KidsLabDe/Robo-Buddy-Makerfestival26/hardware/powerboard/ansichten/2d_oben.png

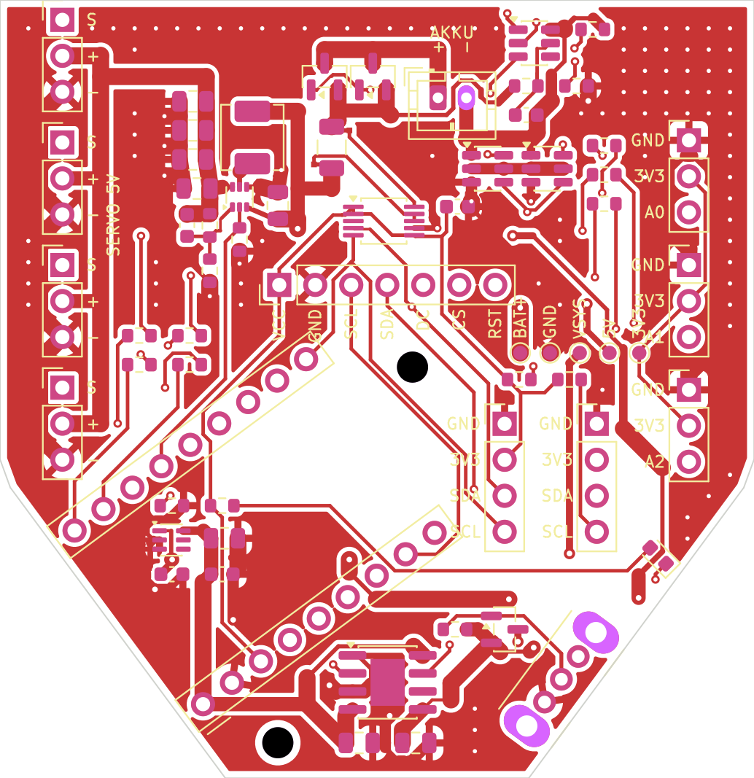
hardware/powerboard/ansichten/2d_oben.png
