KidsLabDe/Robo-Buddy-Makerfestival26/hardware/powerboard/ansichten/2d_unten.png

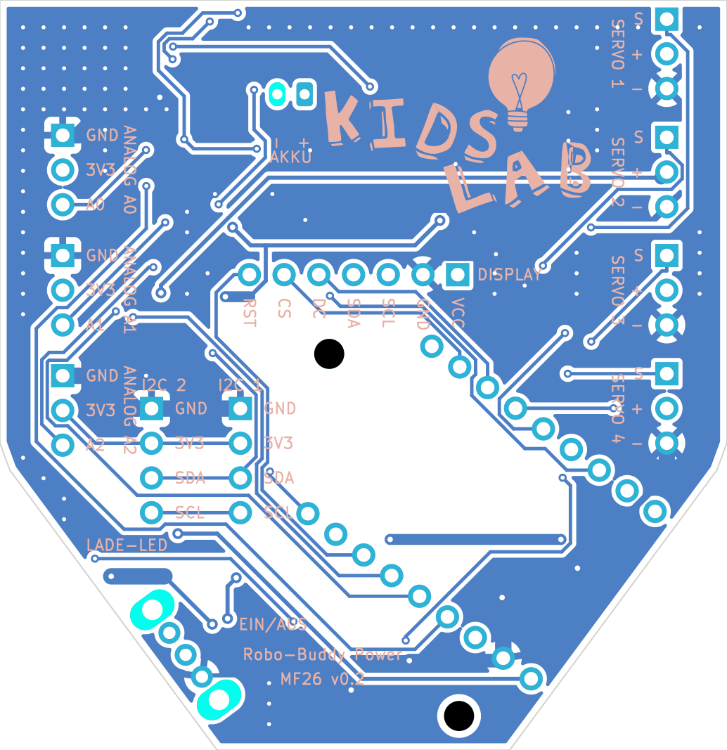
hardware/powerboard/ansichten/2d_unten.png
