KidsLabDe/Robo-Buddy-Makerfestival26/hardware/powerboard/ansichten/3d_oben.png

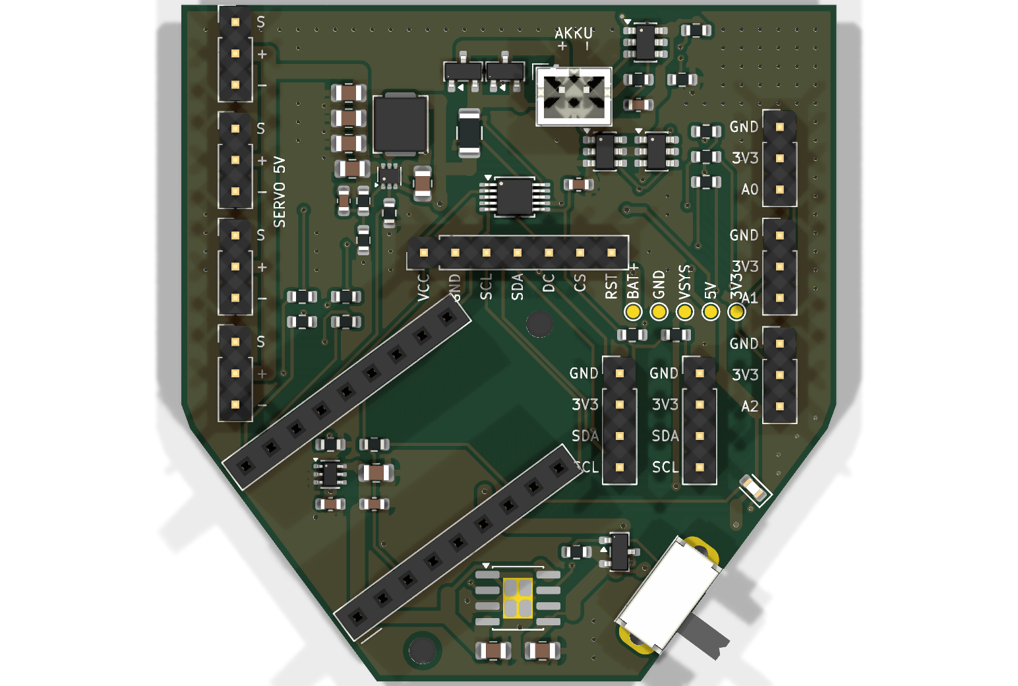
hardware/powerboard/ansichten/3d_oben.png
