KidsLabDe/Robo-Buddy-Makerfestival26/hardware/powerboard/ansichten/3d_schraeg.png

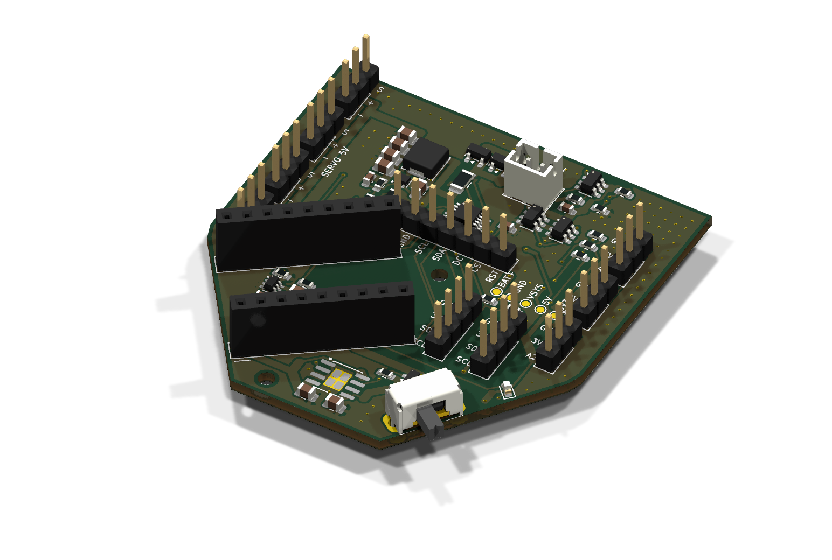
hardware/powerboard/ansichten/3d_schraeg.png
