KidsLabDe/Robo-Buddy-Makerfestival26/hardware/powerboard/ansichten/3d_unten.png

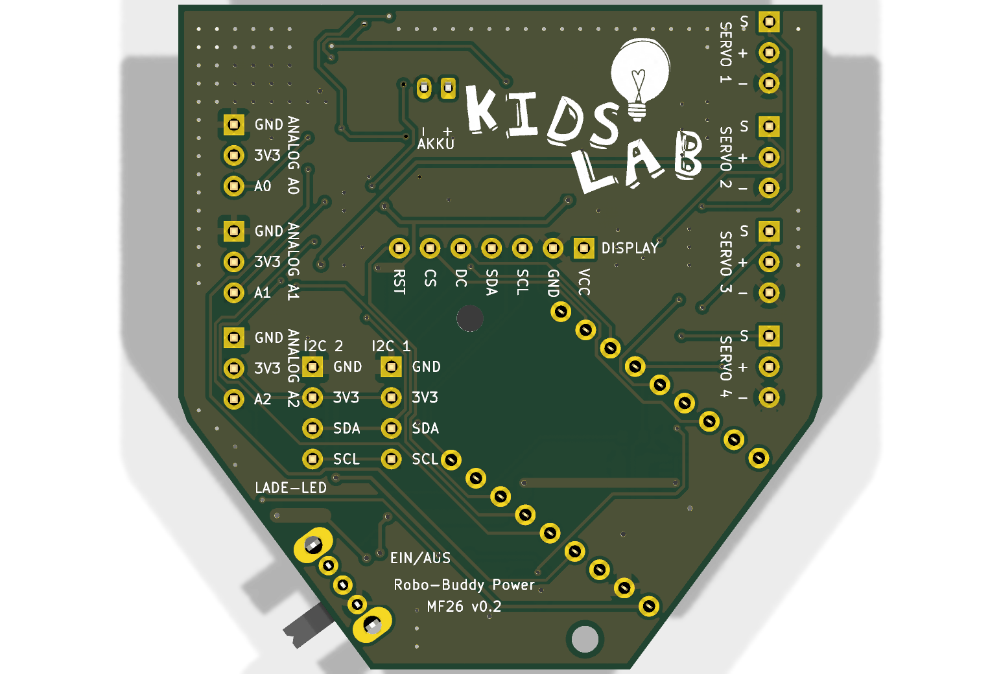
hardware/powerboard/ansichten/3d_unten.png
