KidsLabDe/Robo-Buddy-Makerfestival26/hardware/powerboard/ansichten/passung_schnitte.png

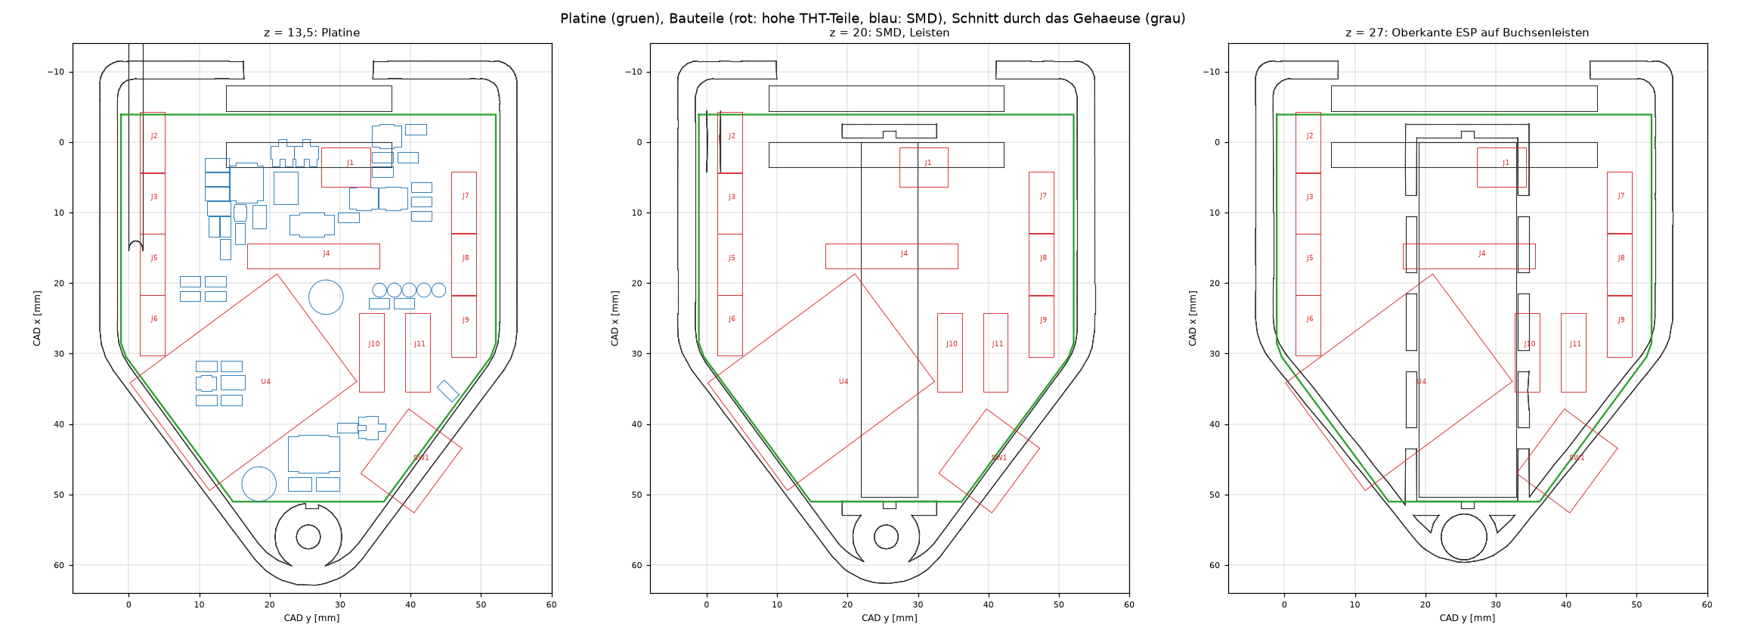
hardware/powerboard/ansichten/passung_schnitte.png
