KidsLabDe/Robo-Buddy-Makerfestival26/hardware/powerboard/ansichten/rework_u3_ce.png

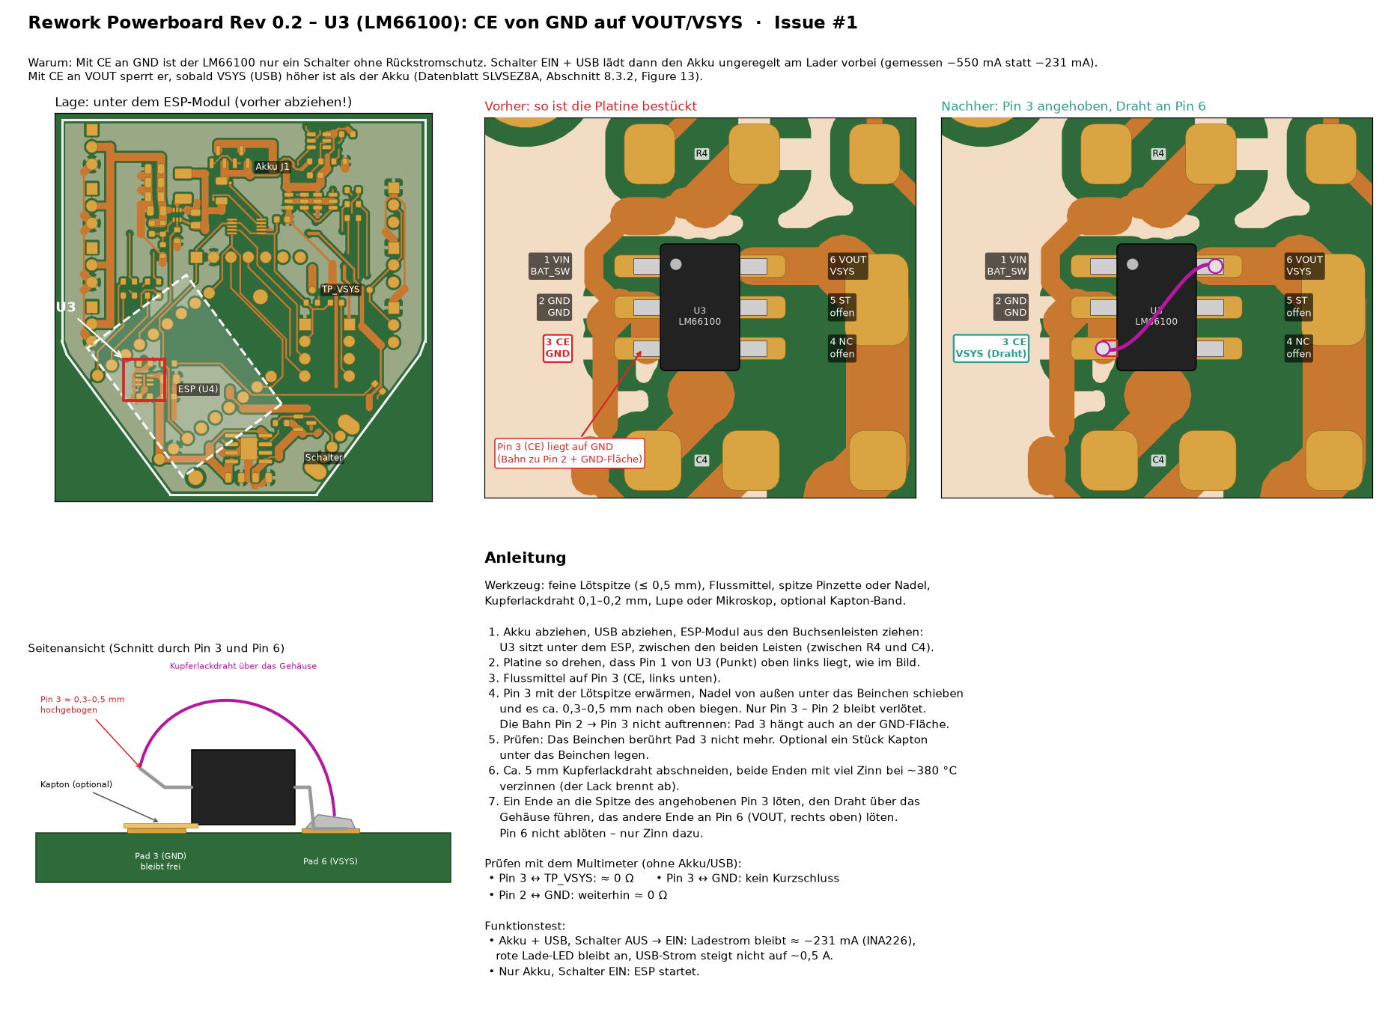
hardware/powerboard/ansichten/rework_u3_ce.png
