KidsLabDe/Robo-Buddy-Makerfestival26/cad/MF26-Roboter-Robot-Base.3mf

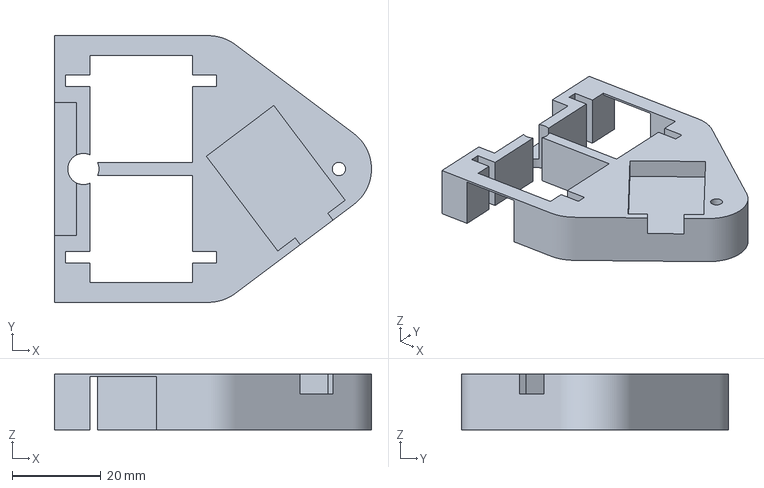
[picture p11: CAD file, 2026-10-15]
cad/MF26-Roboter-Robot-Base.3mf
71.3 x 60.0 x 12.5 mm
