KidsLabDe/Robo-Buddy-Makerfestival26/hardware/powerboard/ansichten/powerboard-umriss-loecher.dxf

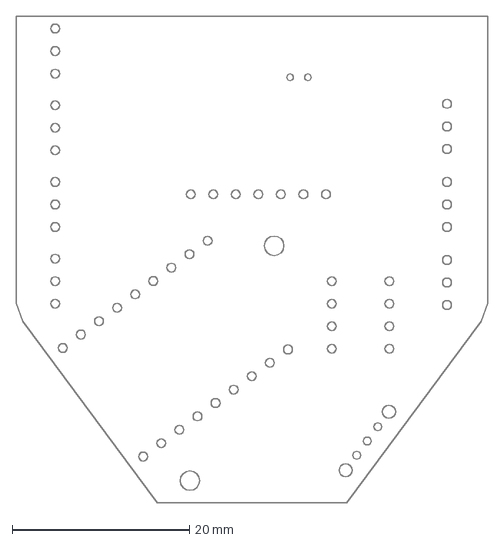
[picture p12: CAD file, 2026-10-22]
hardware/powerboard/ansichten/powerboard-umriss-loecher.dxf
53.2 x 54.9 mm
