KidsLabDe/Robo-Buddy-Makerfestival26/cad/MF26-Roboter-Dragwheel.3mf

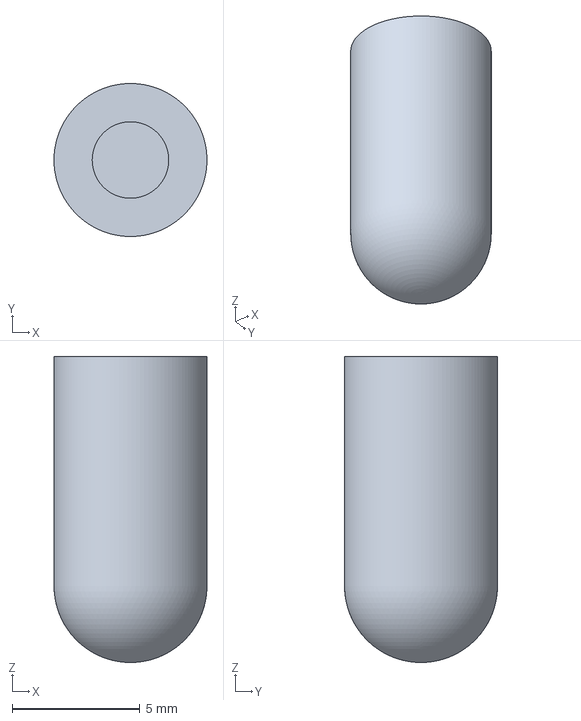
[picture p13: CAD file, 2026-10-15]
cad/MF26-Roboter-Dragwheel.3mf
6.00 x 6.00 x 12.0 mm
