KidsLabDe/Robo-Buddy-Makerfestival26/hardware/powerboard/ansichten/powerboard-umriss.dxf

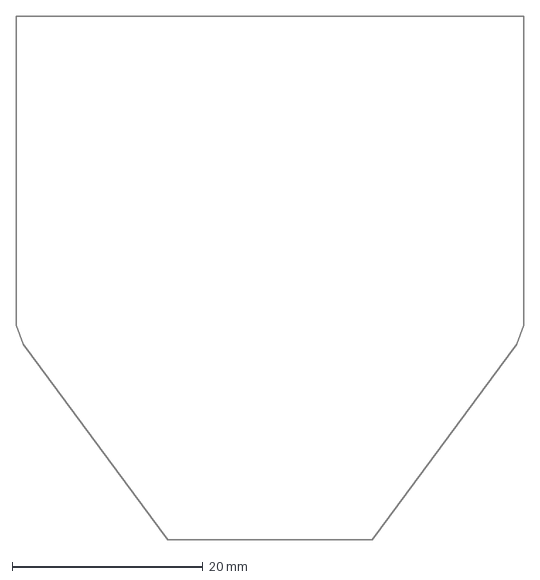
[picture p14: CAD file, 2026-10-22]
hardware/powerboard/ansichten/powerboard-umriss.dxf
53.2 x 54.9 mm
