KidsLabDe/Robo-Buddy-Makerfestival26/cad/MF26-Roboter-Rad.3mf

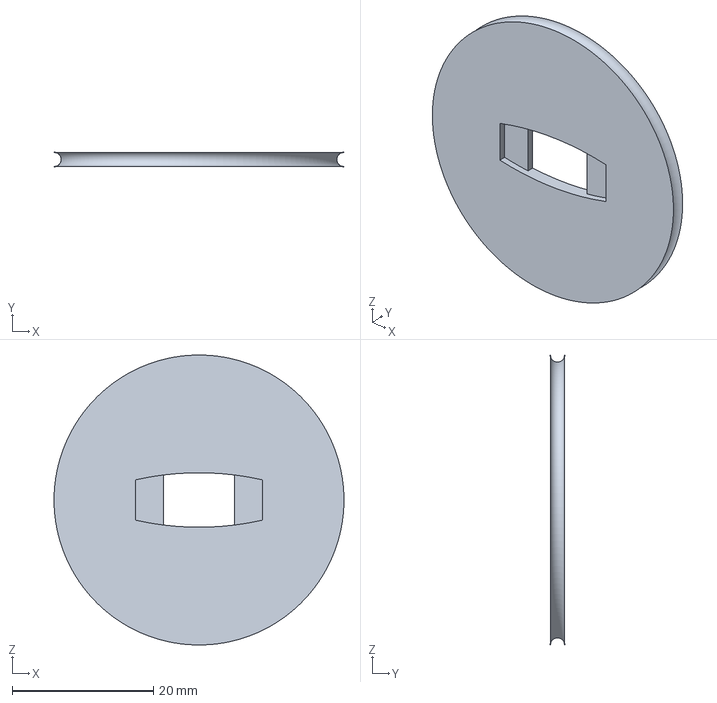
[picture p15: CAD file, 2026-10-15]
cad/MF26-Roboter-Rad.3mf
41.0 x 2.00 x 41.0 mm
