KidsLabDe/Robo-Buddy-Makerfestival26/cad/MF26-Roboter.step

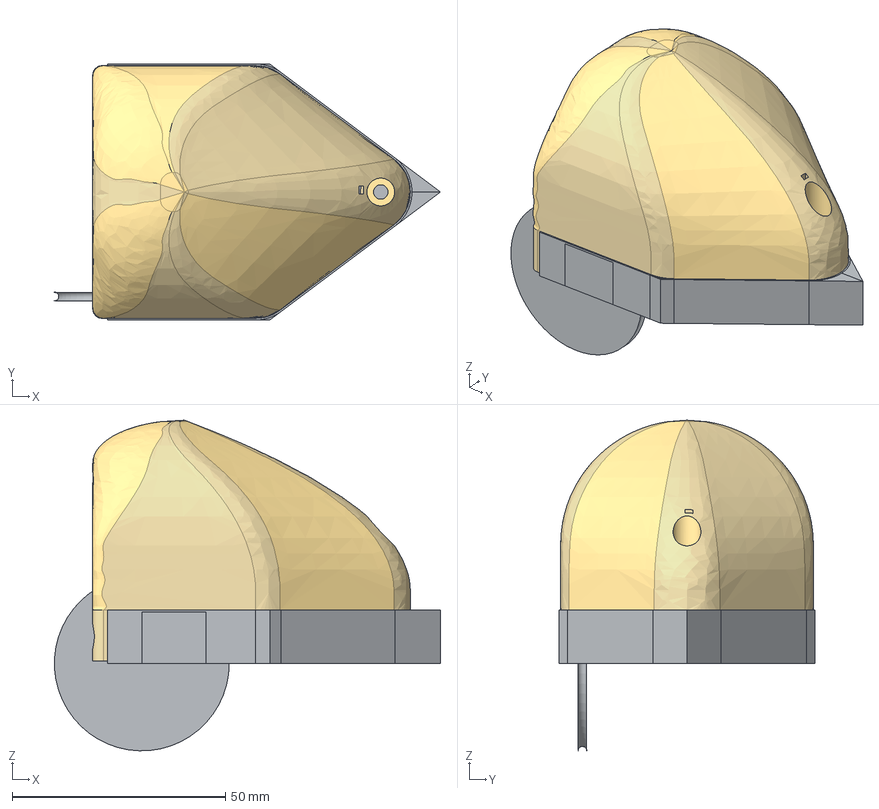
[picture p16: CAD file, 2026-10-08]
cad/MF26-Roboter.step
90.5 x 60.0 x 77.5 mm
Robot-Base
X-Achse x 18
XY-Ebene x 18
Sketch
Sketch002
Sketch003
Sketch004
Sketch005
Sketch006
Sketch007
Sketch008
Display
Sketch009
Huelle
Körper
BaseFeature
Akku
Sketch010
Sketch011
Dragwheel
Sketch012
Sketch013
Sketch014
Sketch015
Sketch016
Sketch001
Rad
