KidsLabDe/Robo-Buddy-Makerfestival26/(list of files, cad)

Other CAD files:
cad/MF26-Roboter-Dragwheel.stl
cad/MF26-Roboter-Rad.stl
cad/MF26-Roboter-Robot-Base.stl
cad/MF26-Roboter.FCStd
