KidsLabDe/Robo-Buddy-Makerfestival26/hardware/powerboard/powerboard.kicad_pcb

## KiCad design hardware/powerboard/powerboard.kicad_pcb (2026-10-08)

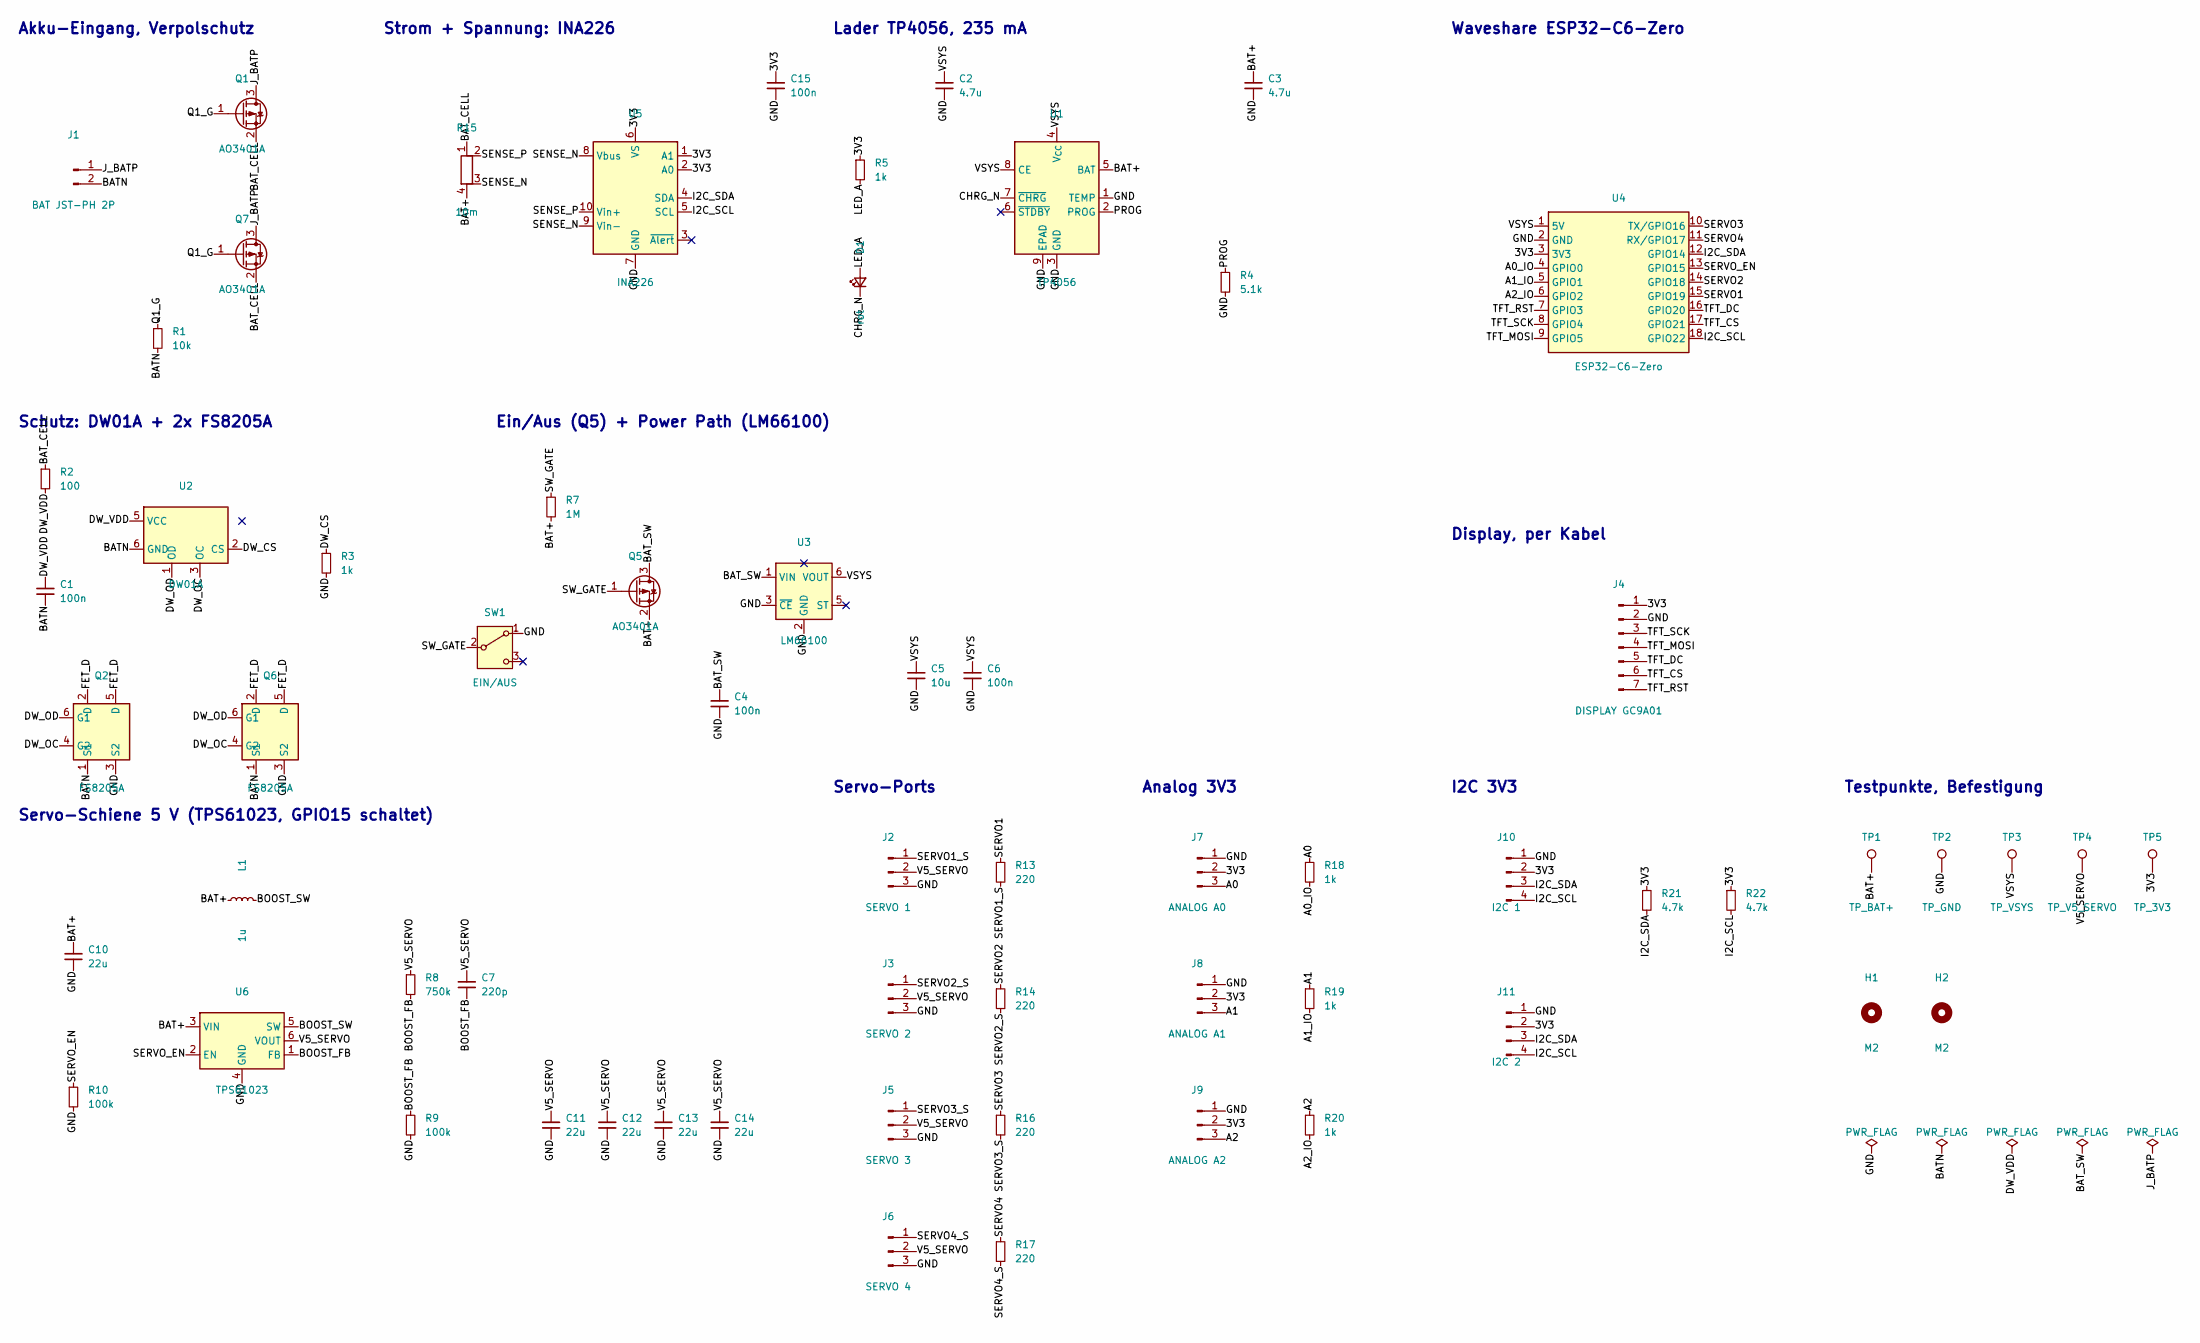
[picture p17: schematic powerboard.kicad_sch, MF26 Robo-Buddy Powerboard]

Parts:
C1, C4, C6, C15: 100n; C_0603_1608Metric; LCSC C14663
C2, C3: 4.7u; C_0805_2012Metric; LCSC C1779
C5: 10u; C_0805_2012Metric; LCSC C15850
C7: 220p; C_0603_1608Metric; LCSC C1603
C10, C11, C12, C13, C14: 22u; C_0805_2012Metric; LCSC C45783
D1: rot; LED_0603_1608Metric; LCSC C2286
H1, H2: M2; MountingHole_2.2mm_M2
J1: BAT JST-PH 2P; JST_PH_B2B-PH-K_1x02_P2.00mm_Vertical
J2: SERVO 1; PinHeader_1x03_P2.54mm_Vertical
J3: SERVO 2; PinHeader_1x03_P2.54mm_Vertical
J4: DISPLAY GC9A01; PinHeader_1x07_P2.54mm_Vertical
J5: SERVO 3; PinHeader_1x03_P2.54mm_Vertical
J6: SERVO 4; PinHeader_1x03_P2.54mm_Vertical
J7: ANALOG A0; PinHeader_1x03_P2.54mm_Vertical
J8: ANALOG A1; PinHeader_1x03_P2.54mm_Vertical
J9: ANALOG A2; PinHeader_1x03_P2.54mm_Vertical
J10: I2C 1; PinHeader_1x04_P2.54mm_Vertical
J11: I2C 2; PinHeader_1x04_P2.54mm_Vertical
L1: 1u; L_Sunlord_MWSA0402S; LCSC C408332
Q1, Q5, Q7: AO3401A; SOT-23; LCSC C15127
Q2, Q6: FS8205A; SOT-23-6; LCSC C908265
R1: 10k; R_0603_1608Metric; LCSC C25804
R2: 100; R_0603_1608Metric; LCSC C22775
R3, R5, R18, R19, R20: 1k; R_0603_1608Metric; LCSC C21190
R4: 5.1k; R_0603_1608Metric; LCSC C23186
R7: 1M; R_0603_1608Metric; LCSC C22935
R8: 750k; R_0603_1608Metric; LCSC C23240
R9, R10: 100k; R_0603_1608Metric; LCSC C25803
R13, R14, R16, R17: 220; R_0603_1608Metric; LCSC C22962
R15: 10m; R_1206_3216Metric_Kelvin; LCSC C105362
R21, R22: 4.7k; R_0603_1608Metric; LCSC C23162
SW1: EIN/AUS; SW_Slide_SPDT_Angled_CK_OS102011MA1Q_Round
TP1: TP_BAT+; TestPoint_Pad_D1.0mm
TP2: TP_GND; TestPoint_Pad_D1.0mm
TP3: TP_VSYS; TestPoint_Pad_D1.0mm
TP4: TP_V5_SERVO; TestPoint_Pad_D1.0mm
TP5: TP_3V3; TestPoint_Pad_D1.0mm
U1: TP4056; SOIC-8-1EP_3.9x4.9mm_P1.27mm_EP2.41x3.3mm; LCSC C16581
U2: DW01A; SOT-23-6; LCSC C2927799
U3: LM66100; SOT-363_SC-70-6; LCSC C2869734
U4: ESP32-C6-Zero; Waveshare_ESP32-C6-Zero_Socket
U5: INA226; TSSOP-10_3x3mm_P0.5mm; LCSC C49851
U6: TPS61023; SOT-563; LCSC C919459

Connections:
/3V3: C15.1, J4.1, J7.2, J8.2, J9.2, J10.2, J11.2, R5.1, R21.1, R22.1, TP5.1, U4.3 (3V3), U5.1 (A1), U5.2 (A0), U5.6 (VS)
/A0: J7.3, R18.1
/A0_IO: R18.2, U4.4 (GPIO0)
/A1: J8.3, R19.1
/A1_IO: R19.2, U4.5 (GPIO1)
/A2: J9.3, R20.1
/A2_IO: R20.2, U4.6 (GPIO2)
/BAT+: C3.1, C10.1, L1.1, Q5.2 (S), R7.2, R15.4, TP1.1, U1.5 (BAT), U6.3 (VIN)
/BATN: C1.2, J1.2, Q2.1 (S1), Q6.1 (S1), R1.2, U2.6 (GND)
/BAT_CELL: Q1.2 (S), Q7.2 (S), R2.1, R15.1
/BAT_SW: C4.1, Q5.3 (D), U3.1 (VIN)
/BOOST_FB: C7.2, R8.2, R9.1, U6.1 (FB)
/BOOST_SW: L1.2, U6.5 (SW)
/CHRG_N: D1.1 (K), U1.7 (~CHRG)
/DW_CS: R3.1, U2.2 (CS)
/DW_OC: Q2.4 (G2), Q6.4 (G2), U2.3 (OC)
/DW_OD: Q2.6 (G1), Q6.6 (G1), U2.1 (OD)
/DW_VDD: C1.1, R2.2, U2.5 (VCC)
/FET_D: Q2.2 (D), Q2.5 (D), Q6.2 (D), Q6.5 (D)
/GND: C2.2, C3.2, C4.2, C5.2, C6.2, C10.2, C11.2, C12.2, C13.2, C14.2, C15.2, J2.3, J3.3, J4.2, J5.3, J6.3, J7.1, J8.1, J9.1, J10.1, J11.1, Q2.3 (S2), Q6.3 (S2), R3.2, R4.2, R9.2, R10.2, SW1.1 (A), TP2.1, U1.1 (TEMP), U1.3 (GND), U1.9 (EPAD), U3.2 (GND), U3.3 (~CE), U4.2 (GND), U5.7 (GND), U6.4 (GND)
/I2C_SCL: J10.4, J11.4, R22.2, U4.18 (GPIO22), U5.5 (SCL)
/I2C_SDA: J10.3, J11.3, R21.2, U4.12 (GPIO14), U5.4 (SDA)
/J_BATP: J1.1, Q1.3 (D), Q7.3 (D)
/LED_A: D1.2 (A), R5.2
/PROG: R4.1, U1.2 (PROG)
/Q1_G: Q1.1 (G), Q7.1 (G), R1.1
/SENSE_N: R15.3, U5.8 (Vbus), U5.9 (Vin-)
/SENSE_P: R15.2, U5.10 (Vin+)
/SERVO1: R13.1, U4.15 (GPIO19)
/SERVO1_S: J2.1, R13.2
/SERVO2: R14.1, U4.14 (GPIO18)
/SERVO2_S: J3.1, R14.2
/SERVO3: R16.1, U4.10 (TX/GPIO16)
/SERVO3_S: J5.1, R16.2
/SERVO4: R17.1, U4.11 (RX/GPIO17)
/SERVO4_S: J6.1, R17.2
/SERVO_EN: R10.1, U4.13 (GPIO15), U6.2 (EN)
/SW_GATE: Q5.1 (G), R7.1, SW1.2 (B)
/TFT_CS: J4.6, U4.17 (GPIO21)
/TFT_DC: J4.5, U4.16 (GPIO20)
/TFT_MOSI: J4.4, U4.9 (GPIO5)
/TFT_RST: J4.7, U4.7 (GPIO3)
/TFT_SCK: J4.3, U4.8 (GPIO4)
/V5_SERVO: C7.1, C11.1, C12.1, C13.1, C14.1, J2.2, J3.2, J5.2, J6.2, R8.1, TP4.1, U6.6 (VOUT)
/VSYS: C2.1, C5.1, C6.1, TP3.1, U1.4 (V_{CC}), U1.8 (CE), U3.6 (VOUT), U4.1 (5V)

Notes on the sheet:
Akku-Eingang, Verpolschutz
Schutz: DW01A + 2x FS8205A
Strom + Spannung: INA226
Lader TP4056, 235 mA
Ein/Aus (Q5) + Power Path (LM66100)
Servo-Schiene 5 V (TPS61023, GPIO15 schaltet)
Servo-Ports
Analog 3V3
I2C 3V3
Waveshare ESP32-C6-Zero
Display, per Kabel
Testpunkte, Befestigung

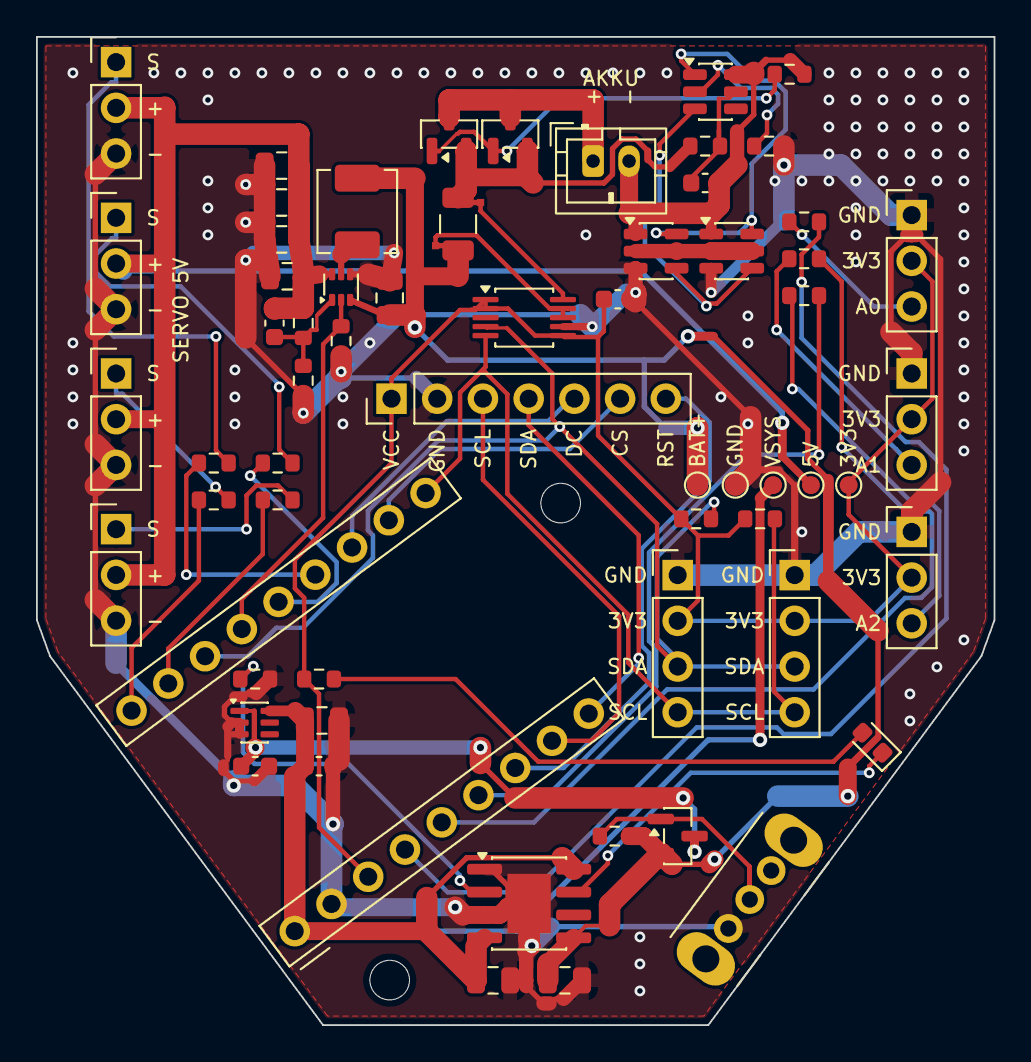
[picture p18: board powerboard.kicad_pcb from above]

Board: 2 copper layers, 53.2 x 54.9 mm, 65 parts (1 on the bottom side), 45 nets.

Other parts of the board:
LOGO1: KidsLab_Logo
