KidsLabDe/Robo-Buddy-Makerfestival26/hardware/powerboard/tools/sexp.py

"""Minimal S-expression reader/writer for KiCad files."""
import re

_tok = re.compile(r'\s*(?:(\()|(\))|("(?:[^"\\]|\\.)*")|([^\s()"]+))')


class Sym(str):
    """Bare (unquoted) atom."""


def parse(text):
    stack, cur = [], []
    pos = 0
    n = len(text)
    while pos < n:
        m = _tok.match(text, pos)
        if not m:
            if text[pos:].strip() == '':
                break
            raise ValueError(f'parse error at {pos}')
        pos = m.end()
        lp, rp, s, a = m.groups()
        if lp:
            stack.append(cur)
            cur = []
        elif rp:
            done = cur
            cur = stack.pop()
            cur.append(done)
        elif s is not None:
            cur.append(s[1:-1].replace('\\"', '"').replace('\\\\', '\\'))
        elif a is not None:
            cur.append(Sym(a))
    return cur[0]


def dump(node, indent=0):
    if isinstance(node, list):
        if not node:
            return '()'
        simple = all(not isinstance(x, list) for x in node)
        if simple:
            return '(' + ' '.join(dump(x) for x in node) + ')'
        pad = '\t' * (indent + 1)
        head = []
        rest = []
        for i, x in enumerate(node):
            if isinstance(x, list):
                rest = node[i:]
                break
            head.append(x)
        out = '(' + ' '.join(dump(x) for x in head)
        for x in rest:
            out += '\n' + pad + dump(x, indent + 1)
        return out + '\n' + '\t' * indent + ')'
    if isinstance(node, Sym):
        return str(node)
    if isinstance(node, bool):
        return 'yes' if node else 'no'
    if isinstance(node, (int, float)):
        return _num(node)
    return '"' + str(node).replace('\\', '\\\\').replace('"', '\\"') + '"'


def _num(v):
    if isinstance(v, int):
        return str(v)
    s = f'{v:.4f}'.rstrip('0').rstrip('.')
    return s if s not in ('-0', '') else '0'


def find(node, key):
    return [x for x in node if isinstance(x, list) and x and x[0] == key]


def find1(node, key):
    r = find(node, key)
    return r[0] if r else None
