KidsLabDe/Robo-Buddy-Makerfestival26/(commit log)

2026-10-07 Add a battery carrier board for the robot: handoff and schematic
    The robot gets a carrier board with charger, cell protection, on/off
    switch and a servo rail fed straight from the cell. The ESP is a
    Waveshare ESP32-C6-Zero; its docs and schematic are kept next to it.
    The KiCad schematic is generated from a part list and passes ERC.
    Claude-Session: https://claude.ai/code/session_01KSMU1rRqVF3P8aDS1qPZSi
    [powerboard.kicad_sch]
2026-10-07 Place the powerboard parts on a first board and render 2D and 3D views
    The outline is a 45 x 30 mm placeholder until the enclosure is known, and
    nothing is routed yet. The board is generated from the schematic so the
    two cannot drift apart, and it shows that every part fits.
    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
    [powerboard.kicad_pcb, powerboard.kicad_sch]
2026-10-08 Add the robot's CAD model (FreeCAD and STEP)
    The powerboard outline and the fit check are taken from it.
    Claude-Session: https://claude.ai/code/session_01UqX4DjfVzW8YQJ4gc8FRQe
    [MF26-Roboter.FCStd, MF26-Roboter.step]
2026-10-08 Route the powerboard Rev 0.2 and add the files for a JLCPCB order
    The board now has four 5 V servo ports through a TPS61023 boost, current
    and voltage measurement with an INA226 on a Kelvin shunt, three analog and
    two I2C ports, a THT cell connector and the outline of the shell. JLC basic
    parts are used where they cost nothing in function.
    The high current path (cell, reverse polarity FETs, shunt, boost, 5 V rail)
    sits in one block at the front and is drawn with fixed, wide copper; the
    autorouter only does signals and low current. Freerouting cannot reach pads
    of parts at odd angles or next to slanted edges, so route.py rewrites the
    DSN for it, tries several variants and keeps the best; maz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
    [powerboard.kicad_pcb, powerboard.kicad_sch, powerboard_bom.csv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]
2026-10-08 Use the 15.24 mm pin row spacing of the ESP32-C6-Zero from Waveshare's DXF
    The footprint assumed 17.78 mm with half pads at the edge; the DXF says
    15.24 mm, with the holes 1.38 mm in from the board edge. The keepout under
    the antenna now follows the row spacing so it stays clear of the pins.
    Board rerouted, views and JLCPCB files regenerated; the BOM rows are now
    sorted in a fixed order.
    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
    [powerboard.kicad_pcb, powerboard_bom.csv]
2026-10-08 orientirenungen für bestellung auf jlcpcb noch angepasst
    [powerboard_cpl.csv]
2026-10-15 cad raus... nur notwendige STL mit dabei
2026-10-22 Powerboard: Umriss als SVG/DXF (mit und ohne Löcher) für CAD/Tinkercad
